SanujaRupasinghe/Machine-Vibration-Monitoring-System/Enclosure Design/Module_Assem/Module_Assem.SLDASM

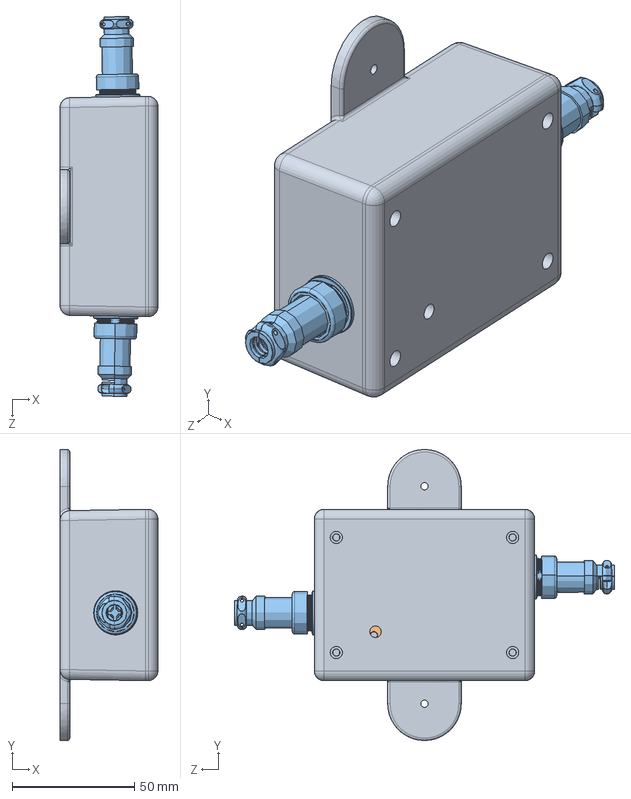
[picture p36: CAD file, 2024-06-19]
Enclosure Design/Module_Assem/Module_Assem.SLDASM
40.0 x 118.8 x 155.2 mm
Module
Sensor_PCB.step
GX16-4P v2.step x 2
