SanujaRupasinghe/Machine-Vibration-Monitoring-System/Enclosure Design/PCB/MCU_PCB.step.SLDASM

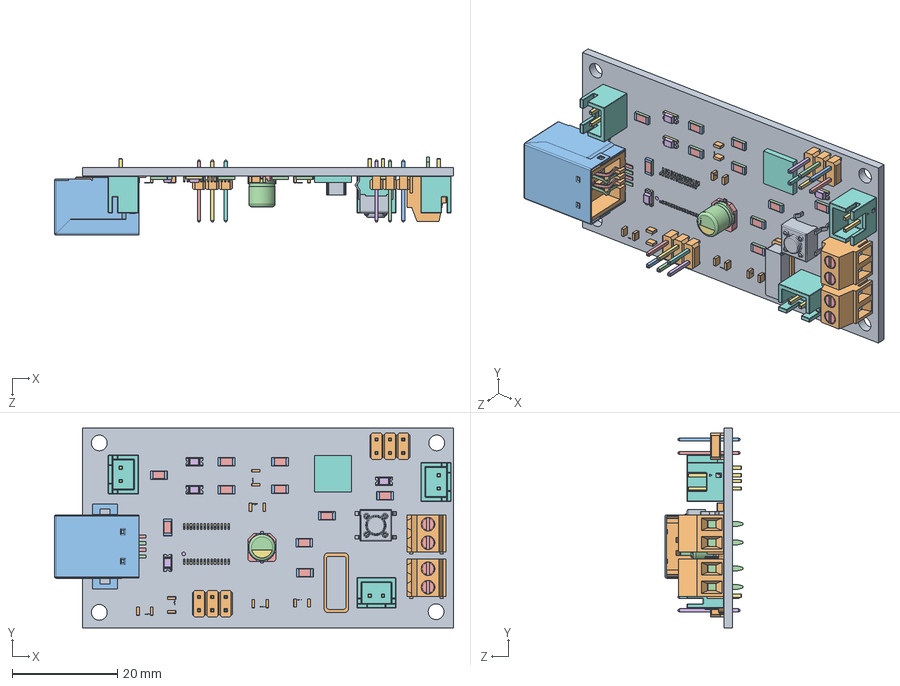
[picture p37: CAD file, 2024-06-19]
Enclosure Design/PCB/MCU_PCB.step.SLDASM
75.7 x 37.8 x 14.8 mm
Conn_Harwin_M20-9980346_eec.step x 2
Conn_Harwin_M20-9980346_eec-0.step x 2
Conn_Harwin_M20-9980346_eec-1.step x 2
Conn_Harwin_M20-9980346_eec-2.step x 2
Conn_Harwin_M20-9980346_eec-3.step x 2
Conn_Harwin_M20-9980346_eec-4.step x 2
Conn_Harwin_M20-9980346_eec-5.step x 2
Extruded.step
Extruded-6.step
Res_Rohm_MCR18ERTFL1R10_eec.step x 10
Res_Rohm_MCR18ERTFL1R10_eec-7.step x 10
Res_Rohm_MCR18ERTFL1R10_eec-8.step x 10
Res_Rohm_MCR18ERTFL1R10_eec-9.step x 10
1-10.step x 3
B2B-XH-A.step x 3
JST Logo adjustable.step x 3
62910416121_Insulator_v2.step
62910416121_Shielding_v2.step
62910416121_Pin_TOP.step x 2
62910416121_Pin_Bottom.step x 2
Leader.step x 28
Extruded-11.step
Switch_C&K_PTS645SM43SMTR92LFS_eec.step
691214110002-12.step x 2
6912141100xx_CAGE.step x 4
6912141100xx_PIN.step x 4
6912141100xx_VIS.step x 4
1-13.step x 4
2.step x 4
3.step x 4
4.step x 4
side.step x 12
Murata.step x 6
___W_____SIZE CODE C-001.step
___W_____SIZE CODE C-002.step
___W_____SIZE CODE C-003.step x 2
1-14.step
Panasonic Logo.step
