SanujaRupasinghe/Machine-Vibration-Monitoring-System/Enclosure Design/PCB/Sensor/Sensor_PCB.step.SLDASM

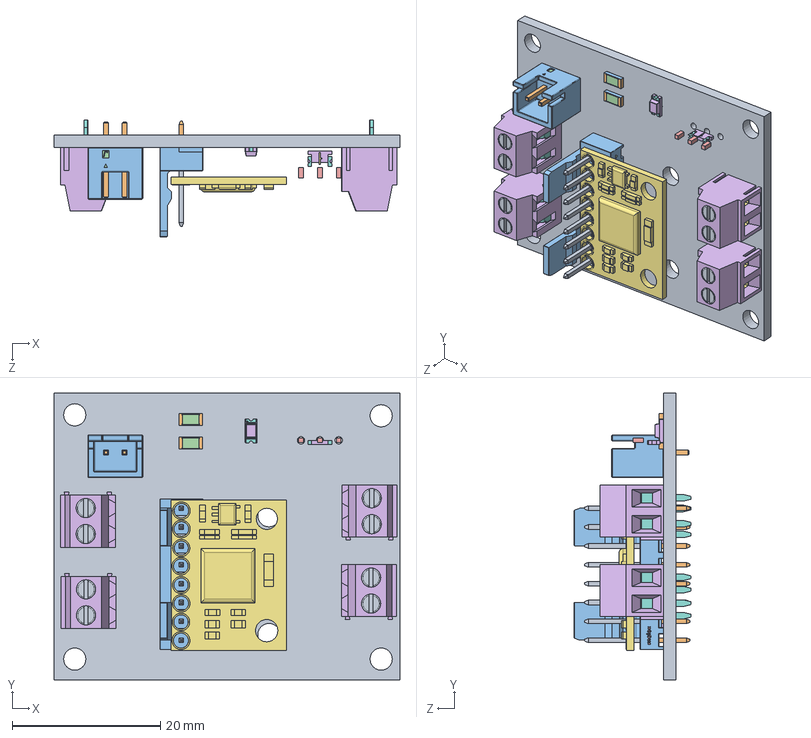
[picture p38: CAD file, 2024-06-19]
Enclosure Design/PCB/Sensor/Sensor_PCB.step.SLDASM
46.6 x 38.6 x 15.7 mm
Res_Rohm_MCR18ERTFL1R10_eec.step x 2
Res_Rohm_MCR18ERTFL1R10_eec-0.step x 2
Res_Rohm_MCR18ERTFL1R10_eec-1.step x 2
Res_Rohm_MCR18ERTFL1R10_eec-2.step x 2
691214110002-12.step x 4
6912141100xx_CAGE.step x 8
6912141100xx_PIN.step x 8
6912141100xx_VIS.step x 8
1-10.step
B2B-XH-A.step
JST Logo adjustable.step
1-5.step
2.step x 2
3.step x 2
4.step x 2
1-6.step
2-7.step
3-8.step
Pin1_Triangle.step
Molex.step
1-13.step
MPU6050.step
