SanujaRupasinghe/Machine-Vibration-Monitoring-System/Enclosure Design/Base/Main_Controller.SLDPRT

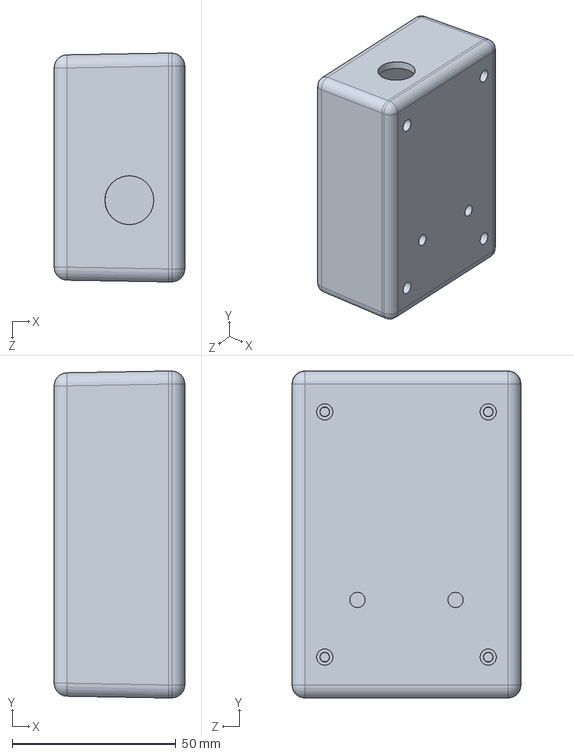
[picture p39: CAD file, 2024-06-19]
Enclosure Design/Base/Main_Controller.SLDPRT
40.0 x 100.0 x 70.0 mm
