SanujaRupasinghe/Machine-Vibration-Monitoring-System/Enclosure Design/Base/Body7.SLDPRT

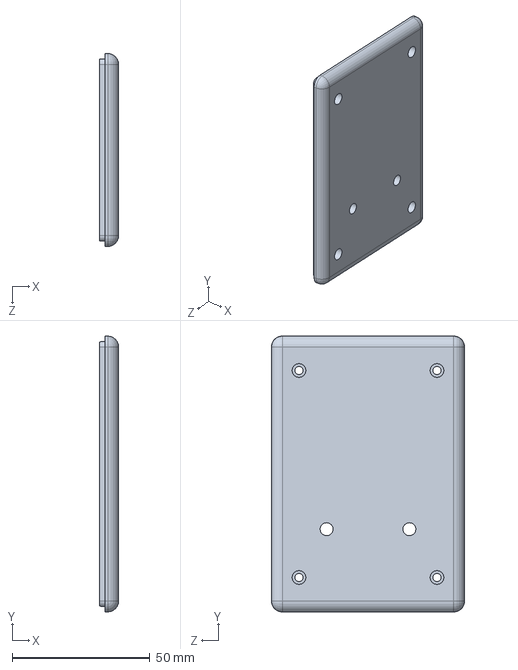
[picture p40: CAD file, 2024-06-19]
Enclosure Design/Base/Body7.SLDPRT
7.00 x 100.0 x 70.0 mm
