SanujaRupasinghe/Machine-Vibration-Monitoring-System/Enclosure Design/Module/Module.SLDPRT

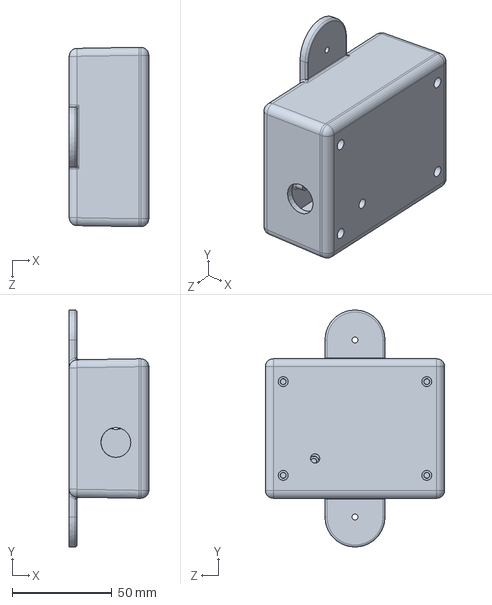
[picture p41: CAD file, 2024-06-19]
Enclosure Design/Module/Module.SLDPRT
40.0 x 118.8 x 90.0 mm
