SanujaRupasinghe/Machine-Vibration-Monitoring-System/Enclosure Design/Port/GX16-4P v2.step.SLDPRT

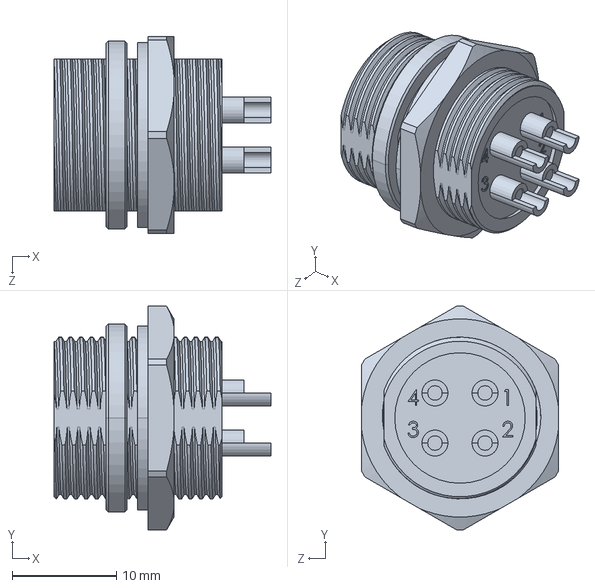
[picture p42: CAD file, 2024-06-19]
Enclosure Design/Port/GX16-4P v2.step.SLDPRT
20.8 x 21.4 x 18.9 mm
