SanujaRupasinghe/Machine-Vibration-Monitoring-System/Enclosure Design/STL/Main_Controller/Body6.STL

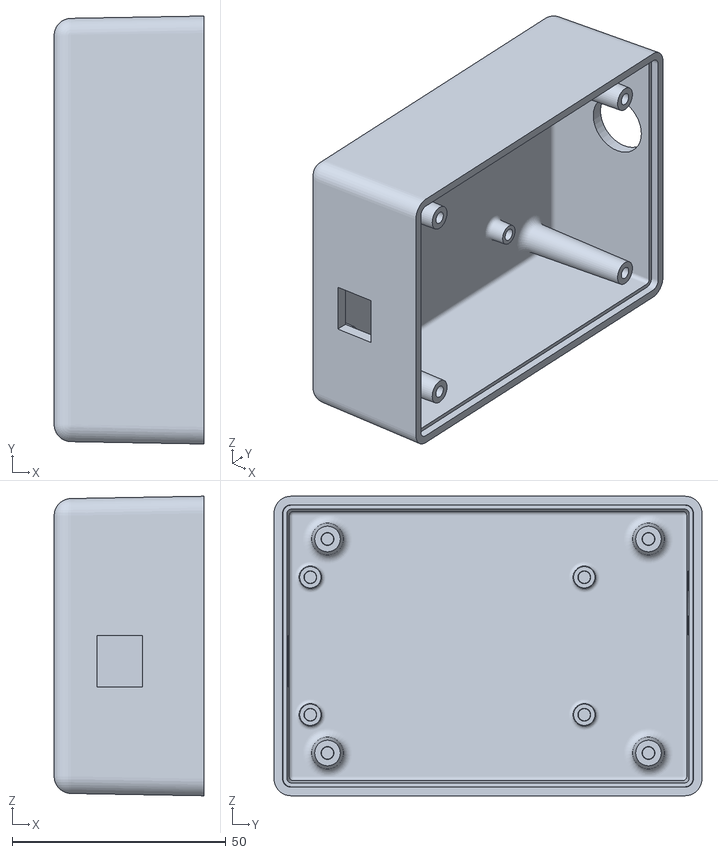
[picture p43: CAD file, 2024-06-19]
Enclosure Design/STL/Main_Controller/Body6.STL
35.0 x 100.0 x 70.0
