SanujaRupasinghe/Machine-Vibration-Monitoring-System/PCB Design/EDR_MCU_PCB_CH340_v1/CH340/Ch340G--3DModel-STEP-56544.STEP

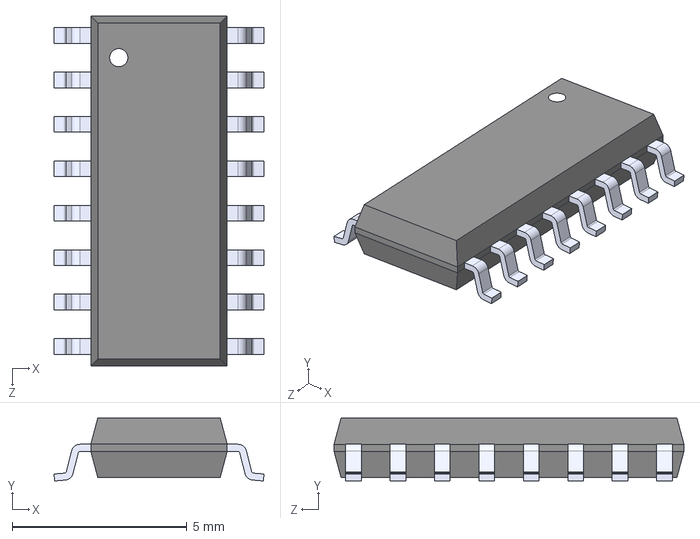
[picture p44: CAD file, 2024-06-19]
PCB Design/EDR_MCU_PCB_CH340_v1/CH340/Ch340G--3DModel-STEP-56544.STEP
6.00 x 1.80 x 10.0 mm
