SanujaRupasinghe/Machine-Vibration-Monitoring-System/PCB Design/EDR_Sensor_PCB_v1/MPU6050.step

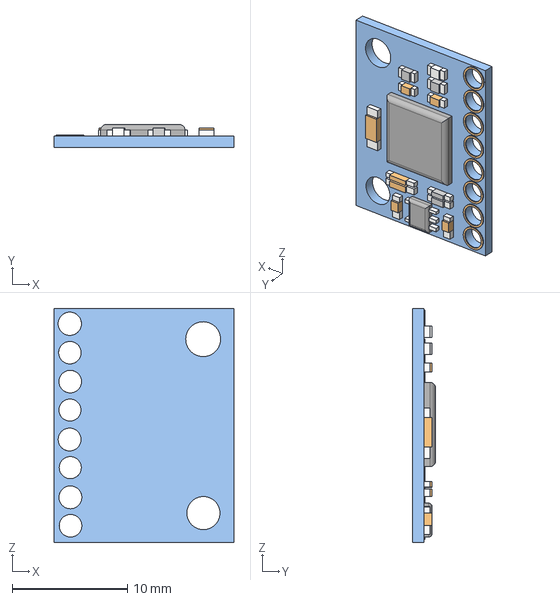
[picture p45: CAD file, 2024-06-19]
PCB Design/EDR_Sensor_PCB_v1/MPU6050.step
15.6 x 2.00 x 20.3 mm
