SanujaRupasinghe/Machine-Vibration-Monitoring-System/Enclosure Design/Module/Split1_Base_Lid[1]_Lid.SLDPRT

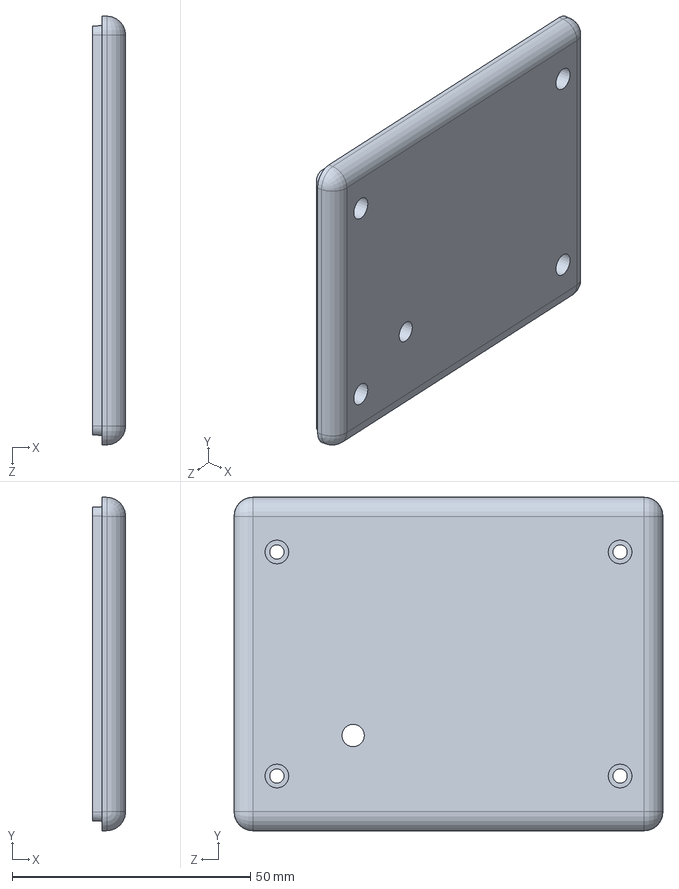
[picture p46: CAD file, 2024-06-19]
Enclosure Design/Module/Split1_Base_Lid[1]_Lid.SLDPRT
7.00 x 70.0 x 90.0 mm
