SanujaRupasinghe/Machine-Vibration-Monitoring-System/Enclosure Design/Module/Split1_Base_Lid[2]_Base.SLDPRT

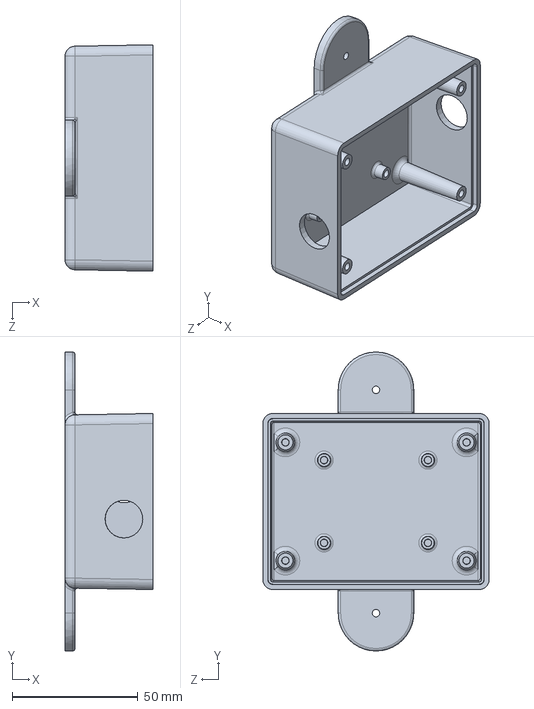
[picture p47: CAD file, 2024-06-19]
Enclosure Design/Module/Split1_Base_Lid[2]_Base.SLDPRT
35.0 x 118.8 x 90.0 mm
