SanujaRupasinghe/Machine-Vibration-Monitoring-System/(list of files, cad)

Other CAD files:
Enclosure Design/PCB/Sensor/Sensor_PCB.step
Enclosure Design/STL/Main_Controller/Body7.STL
Enclosure Design/Base/Body6.SLDPRT
Enclosure Design/DOCS/Main_Controller_Base.SLDDRW
Enclosure Design/DOCS/Main_Controller_Lid.SLDDRW
Enclosure Design/DOCS/Module_Base.SLDDRW
Enclosure Design/DOCS/Module_Lid.SLDDRW
Enclosure Design/PCB/Sensor/Sensor_PCB.step.SLDPRT
Enclosure Design/STL/Module/Split1_Base_Lid[1]_Lid.STL
Enclosure Design/STL/Module/Split1_Base_Lid[2]_Base.STL
