SanujaRupasinghe/Machine-Vibration-Monitoring-System/Enclosure Design/DOCS/All_Enclosure.pdf

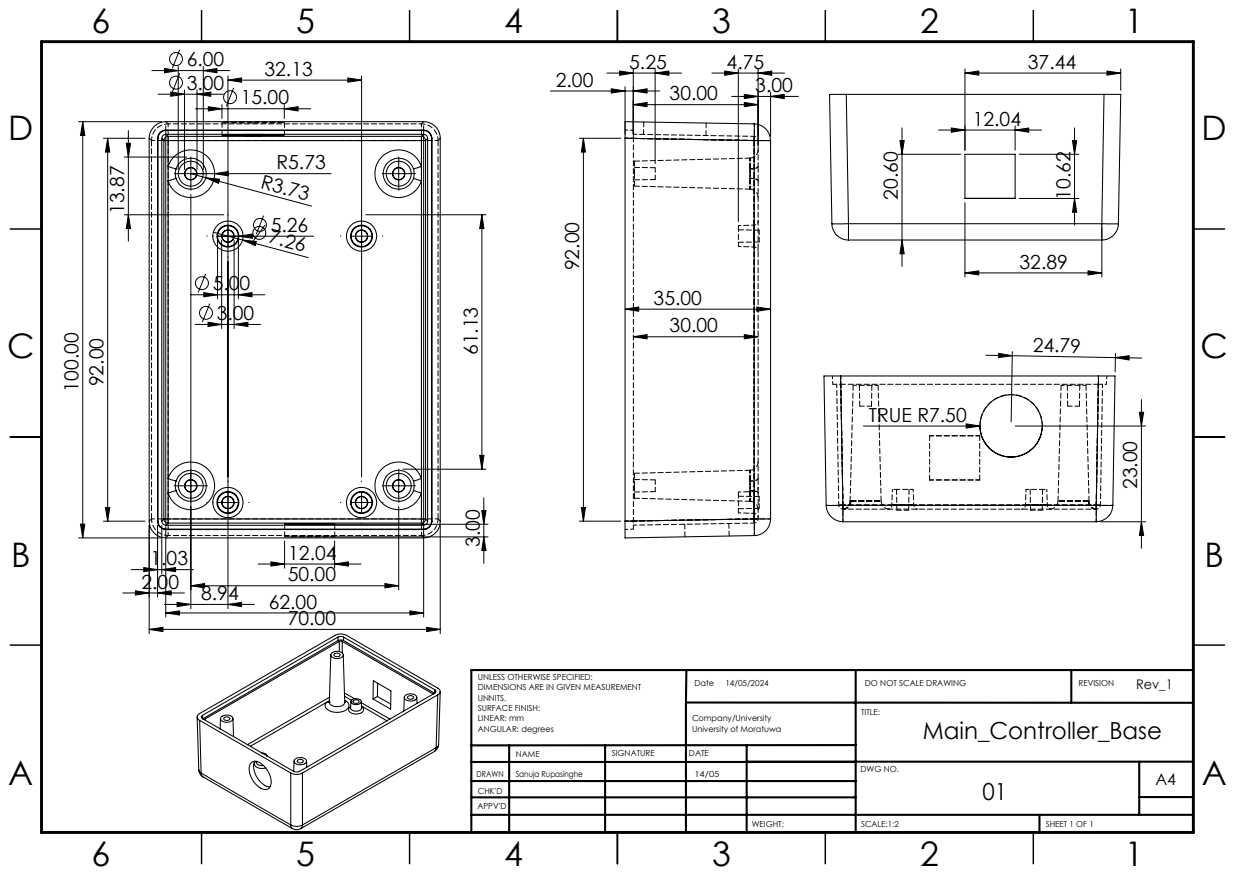
[picture p48: page 1]
TRUE R7.50

UNLESS OTHERWISE SPECIFIED: DIMENSIONS ARE IN GIVEN MEASUREMENT UNNITS. SURFACE FINISH: LINEAR: mm ANGULAR: degrees | Date 14/05/2024 | DO NOT SCALE DRAWING | Rev_1 REVISION

Company/University University of Moratuwa | TITLE: Main_Controller_Base

NAME | SIGNATURE | DATE

DRAWN | Sanuja Rupasinghe | | 14/05 | | DWG NO. 01 | A4

CHK'D
APPV'D

WEIGHT: | SCALE:1:2 | SHEET 1 OF 1

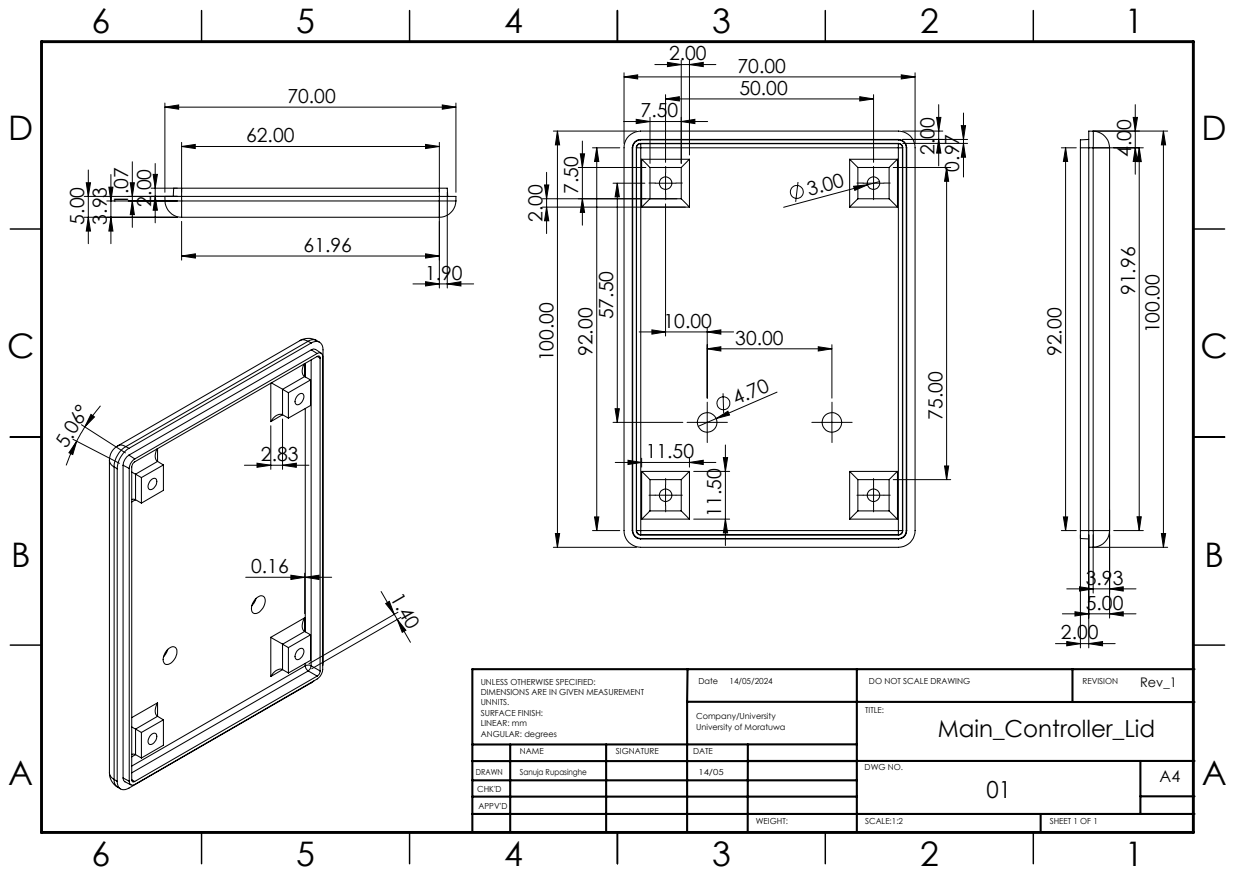
[picture p49: page 2]

UNLESS OTHERWISE SPECIFIED: DIMENSIONS ARE IN GIVEN MEASUREMENT UNNITS. SURFACE FINISH: LINEAR: mm ANGULAR: degrees | Date 14/05/2024 | DO NOT SCALE DRAWING | REVISION Rev_1

Company/University University of Moratuwa | TITLE: Main_Controller_Lid

NAME | SIGNATURE | DATE

DRAWN | Sanuja Rupasinghe | | 14/05 | DWG NO. 01 | A4

CHK'D

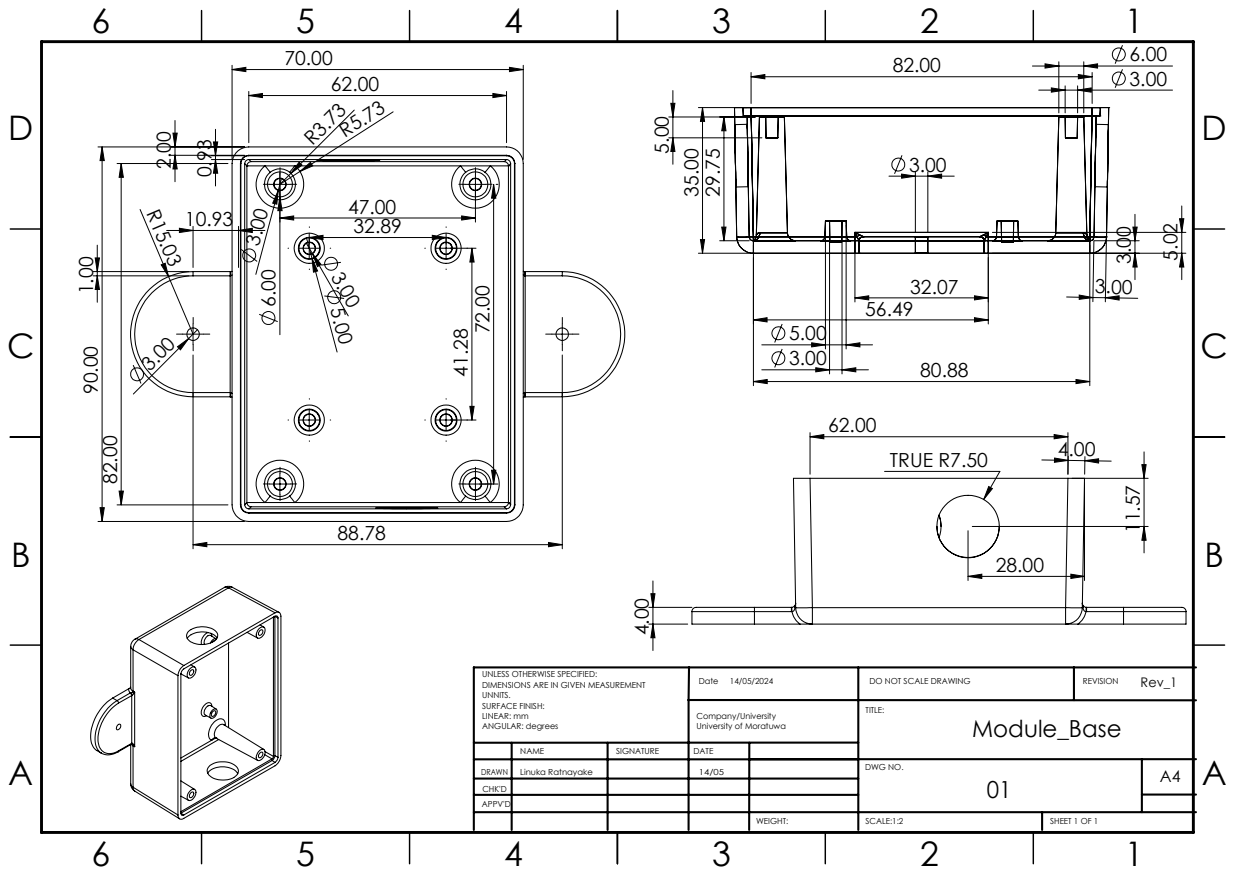
[picture p50: page 3]
TRUE R7.50

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

Company/University University of Moratuwa | TITLE: Module_Base

NAME | SIGNATURE | DATE

DRAWN | Linuka Ratnayake | | 14/05 | DWG NO. 01 | A4

CHK'D

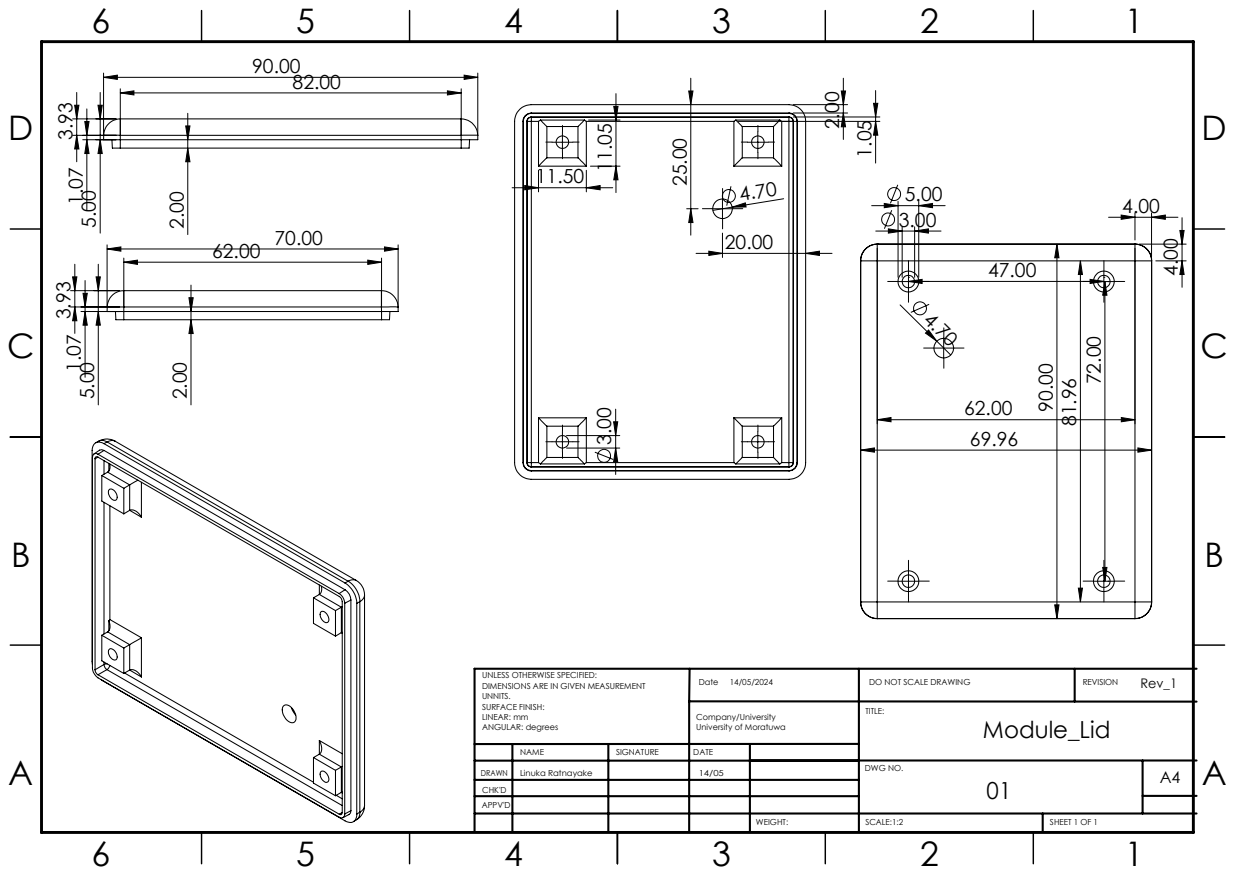
[picture p51: page 4]
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

Company/University University of Moratuwa | TITLE: Module_Lid

NAME | SIGNATURE | DATE

DRAWN | Linuka Ratnayake | | 14/05 | DWG NO. 01 | A4

CHK'D
