SanujaRupasinghe/Machine-Vibration-Monitoring-System/(list of files, drawings)

Other design files:
PCB Design/EDR_MCU_PCB_CH340_v1/ATmega.SchDoc
PCB Design/EDR_MCU_PCB_CH340_v1/CH340.SchDoc
PCB Design/EDR_MCU_PCB_CH340_v1/EDR_MCU_PCB_CH340_v1.PrjPcb
PCB Design/EDR_MCU_PCB_CH340_v1/Main.SchDoc
PCB Design/EDR_MCU_PCB_CH340_v1/MCU_PCB.PcbDoc
PCB Design/EDR_MCU_PCB_FTDI_v1/ATmega.SchDoc
PCB Design/EDR_MCU_PCB_FTDI_v1/EDR_MCU_PCB_FTDI_v1.PrjPcb
PCB Design/EDR_MCU_PCB_FTDI_v1/FTDI.SchDoc
PCB Design/EDR_MCU_PCB_FTDI_v1/Main.SchDoc
PCB Design/EDR_MCU_PCB_FTDI_v1/MCU_PCB.PcbDoc
PCB Design/EDR_Sensor_PCB_v1/EDR_Sensor_PCB_v1.PrjPcb
PCB Design/EDR_Sensor_PCB_v1/Schematic.SchDoc
PCB Design/EDR_Sensor_PCB_v1/Sensor_PCB.PcbDoc
PCB Design/PCB_Stencils/MCU_PCB_CH340.PcbDoc
PCB Design/PCB_Stencils/MCU_PCB_FTDI.PcbDoc
PCB Design/PCB_Stencils/PCB_Stencils.PcbDoc
PCB Design/PCB_Stencils/PCB_Stencils.PrjPcb
