SanujaRupasinghe/Machine-Vibration-Monitoring-System/(commit log)

2024-06-19 Add PCB design files
    [ATmega.SchDoc, CH340.SchDoc, Ch340G--3DModel-STEP-56544.STEP, EDR_MCU_PCB_CH340_v1.PrjPcb, EDR_MCU_PCB_FTDI_v1.PrjPcb, EDR_Sensor_PCB_v1.PrjPcb, FTDI.SchDoc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]
2024-06-19 Add placeholders for enclosure and documentation
2024-06-19 enclosure design files are added
    [Body6.SLDPRT, Body6.STL, Body7.SLDPRT, Body7.STL, GX16-4P v2.step.SLDPRT, MCU_PCB.step.SLDASM, Main_Controller.SLDPRT, Main_Controller_Base.SLDDRW]
2024-07-09 Add document of photographs
    Contains photographs of:
    - PCB (soldered and before soldering)
    - Enclosure
    - System Integration (Hardware and Software)
